mhacks/hacker-boards-refactor/hardware/rev4/hacker-boards-refactor.brd

## EAGLE design hardware/rev4/hacker-boards-refactor.brd (2016-09-08)

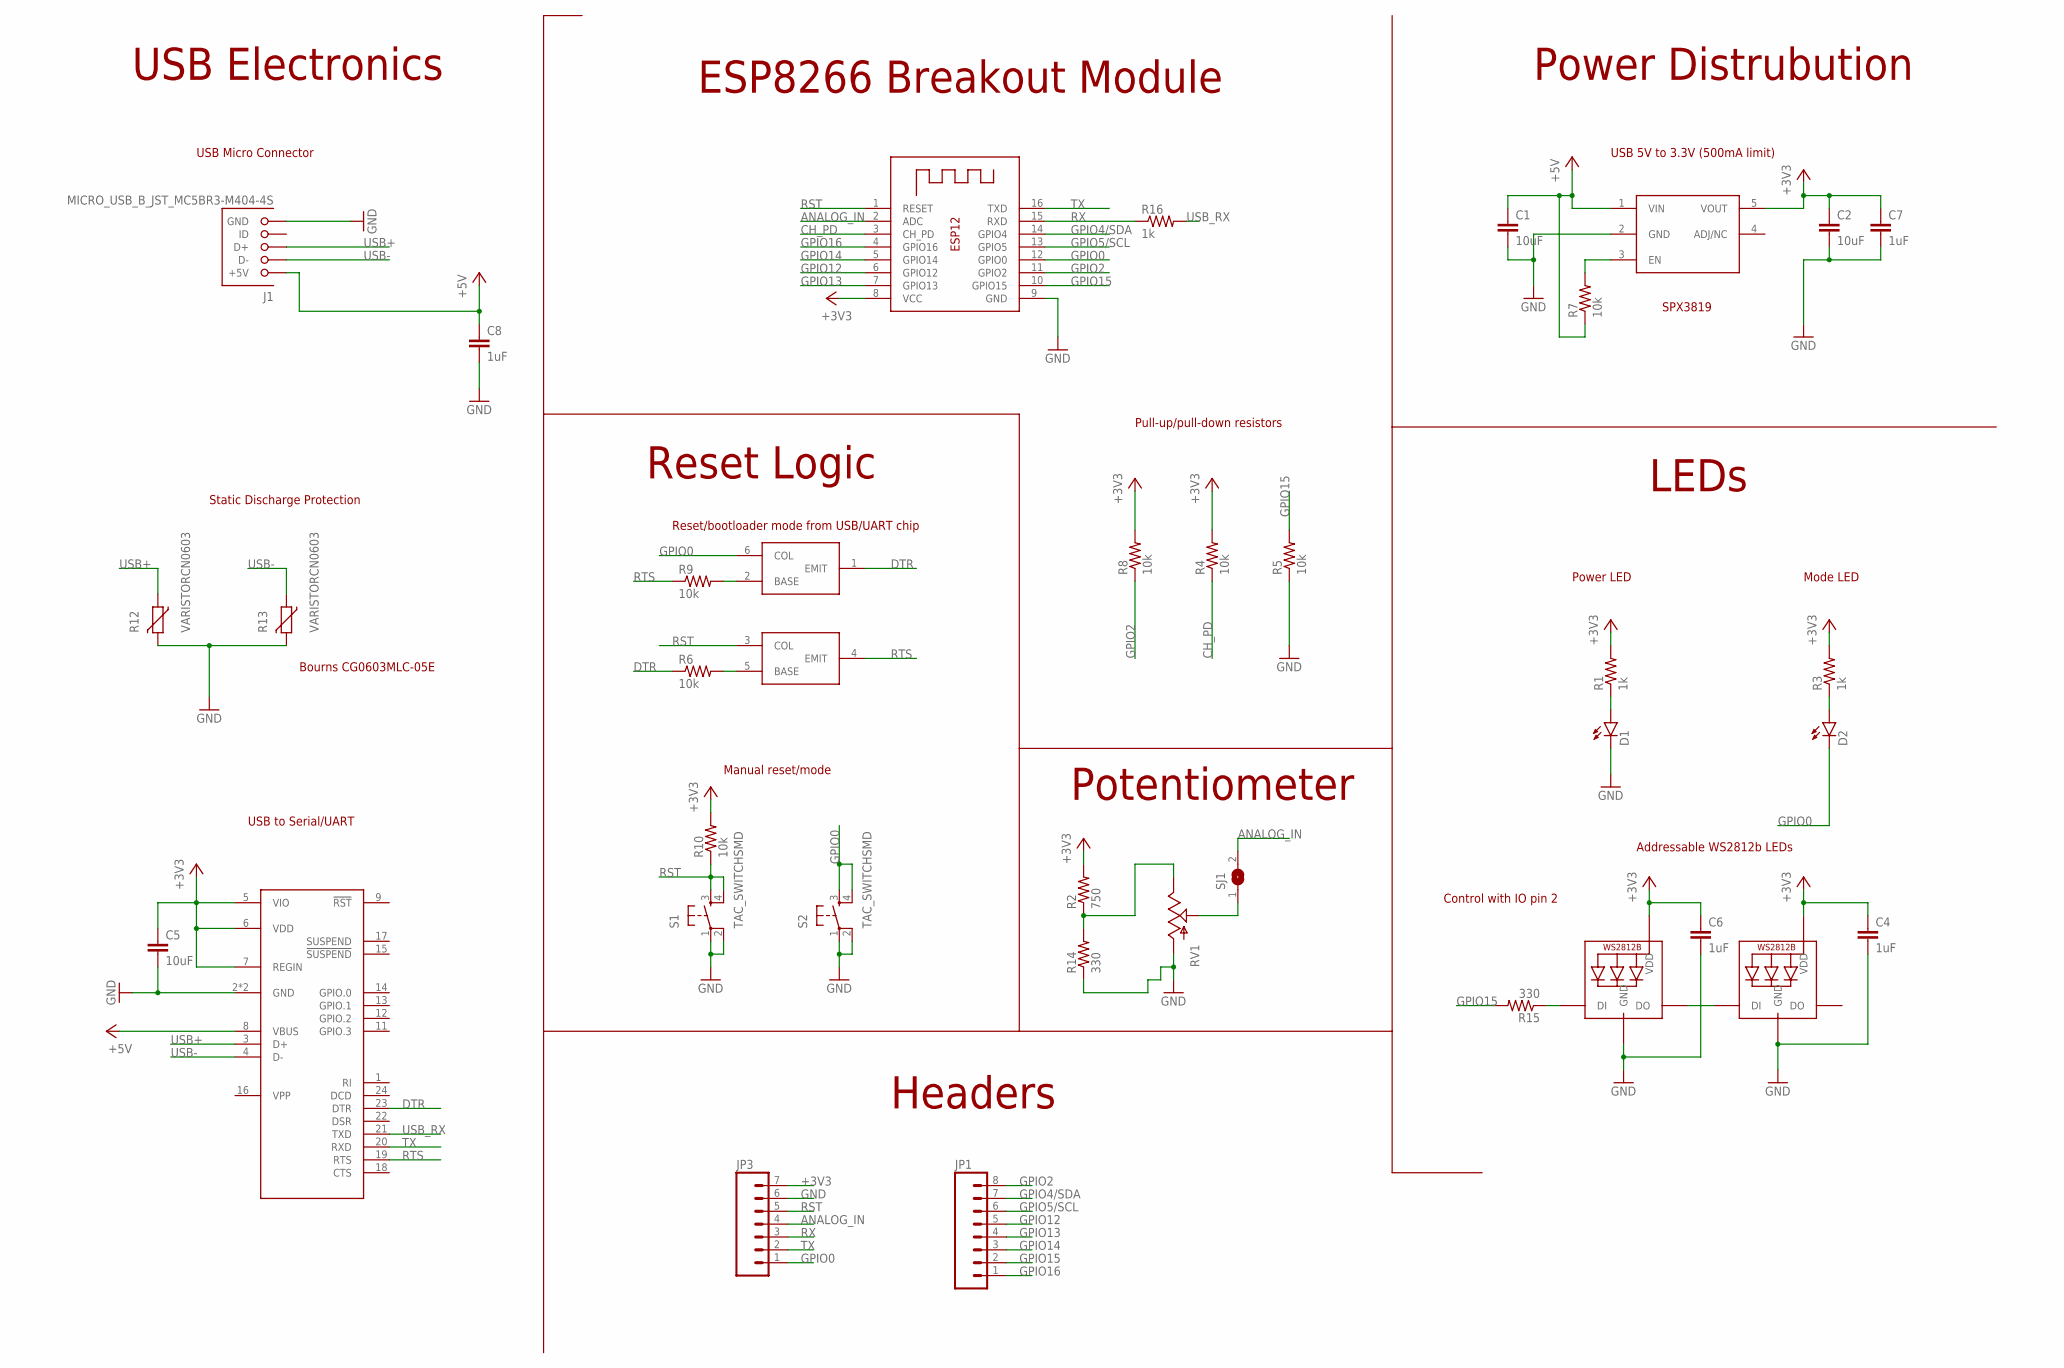
[picture p1: schematic hacker-boards-refactor.sch]

Parts:
C1, C2, C5: 10uF; C0805
C4, C6, C7, C8: 1uF; C0402
D1, D2: LED0603; LED-0603
J1: MICRO_USB_B_JST_MC5BR3-M404-4S; USB_MICRO_B-JST-MC5BR3-M404-4S-TB
JP1: M08; 1X08_ROUND
JP3: M07; 1X07
LED1, LED2: WS2812B5050; WS2812B
R1, R3, R16: 1k; R0402
R2: 750; R0402
R4, R5, R6, R7, R8, R9, R10: 10k; R0402
R12, R13: VARISTORCN0603; CT/CN0603
R14, R15: 330; R0402
RV1: POTALPS-KIT; ALPS_POT_KIT
S1, S2: TAC_SWITCHSMD; TACTILE-SWITCH-SMD
SJ1: SJ
U$2: AP2112; SOT23-5L
U$3: CP2104; QFN24_4X4
U$4: MBT3904DW1T1G; SOT363
X1: ESP-12

Connections:
+3V3: C2.1, C4.1, C5.1, C6.1, C7.1, JP3.7, LED1.1-VDD (VDD), LED2.1-VDD (VDD), R1.2, R2.2, R3.2, R4.2, R8.2, R10.2, U$2.5 (VOUT), U$3.5 (VIO), U$3.6 (VDD), U$3.7 (REGIN), X1.8 (VCC)
+5V: C1.1, C8.1, J1.1 (+5V), R7.1, U$2.1 (VIN), U$3.8 (VBUS)
ANALOG_IN: JP3.4, SJ1.2, X1.2 (ADC)
CH_PD: R4.1, X1.3 (CH_PD)
DTR: R6.1, U$3.23 (DTR), U$4.1 (EMIT)
GND: C1.2, C2.2, C4.2, C5.2, C6.2, C7.2, C8.2, D1.C, J1.5 (GND), JP3.6, LED1.3-GND (GND), LED2.3-GND (GND), R5.1, R12.2, R13.2, R14.1, RV1.P$3 (A), S1.1, S1.2, S2.1, S2.2, U$2.2 (GND), U$3.2 (GND), U$3.25 (GND), X1.9 (GND)
GPIO0: D2.C, JP3.1, S2.3, S2.4, U$4.6 (COL), X1.12 (GPIO0)
GPIO2: JP1.8, R8.1, X1.11 (GPIO2)
GPIO4/SDA: JP1.7, X1.14 (GPIO4)
GPIO5/SCL: JP1.6, X1.13 (GPIO5)
GPIO12: JP1.5, X1.6 (GPIO12)
GPIO13: JP1.4, X1.7 (GPIO13)
GPIO14: JP1.3, X1.5 (GPIO14)
GPIO15: JP1.2, R5.2, R15.2, X1.10 (GPIO15)
GPIO16: JP1.1, X1.4 (GPIO16)
unnamed: D1.A, R1.1
unnamed: D2.A, R3.1
unnamed: R2.1, R14.2, RV1.P$1 (E)
unnamed: LED1.2-DOUT (DO), LED2.4-DIN (DI)
unnamed: LED1.4-DIN (DI), R15.1
unnamed: R7.2, U$2.3 (EN)
unnamed: R9.2, U$4.2 (BASE)
unnamed: R6.2, U$4.5 (BASE)
unnamed: RV1.P$2 (S), SJ1.1
RST: JP3.5, R10.1, S1.3, S1.4, U$4.3 (COL), X1.1 (RESET)
RTS: R9.1, U$3.19 (RTS), U$4.4 (EMIT)
RX: JP3.3, R16.1, X1.15 (RXD)
TX: JP3.2, U$3.20 (RXD), X1.16 (TXD)
USB+: J1.3 (D+), R12.1, U$3.3 (D+)
USB-: J1.2 (D-), R13.1, U$3.4 (D-)
USB_RX: R16.2, U$3.21 (TXD)

Notes on the sheet:
Power Distrubution
LEDs
Headers
Potentiometer
Reset Logic
ESP8266 Breakout Module
USB Electronics
USB Micro Connector
Static Discharge Protection
USB to Serial/UART
Pull-up/pull-down resistors
Reset/bootloader mode from USB/UART chip
Manual reset/mode
Power LED
Mode LED
Addressable WS2812b LEDs
Control with IO pin 2
USB 5V to 3.3V (500mA limit)
Bourns CG0603MLC-05E
SPX3819

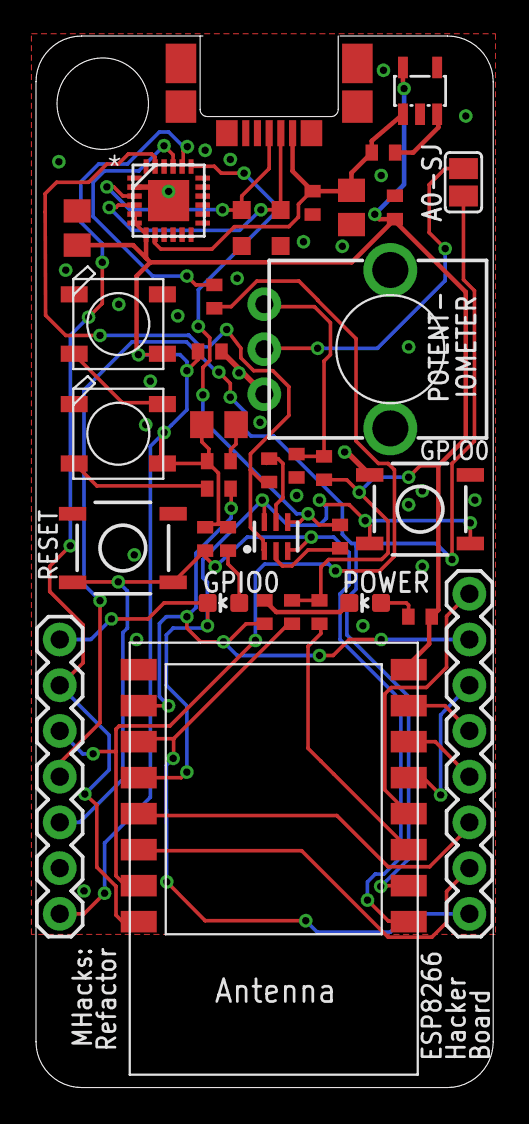
[picture p2: board hardware/rev4/hacker-boards-refactor.brd from above]

Board: 2 copper layers, 25.4 x 58.4 mm, 38 parts (1 on the bottom side), 31 nets.

Other parts of the board:
U$1: LOGO8EDGY
