mhacks/hacker-boards-refactor/(commit log)

2015-12-19 Initial Schematic Commit
    [hacker-boards-refactor.sch]
2015-12-19 Added 0402, 0603, 0805 resistors
2015-12-20 Added USB parts, reset logic, headers, LEDs. Cleaned up.
    [hacker-boards-refactor.sch]
2015-12-20 Current limiting resistor on data pin of WS2812, decoupling caps on power lines
    [hacker-boards-refactor.sch]
2015-12-20 Added potentiometer and ESD protection for USB
    [hacker-boards-refactor.sch]
2015-12-21 Initial board commit (with autorouted traces), schematic cleanup
    [hacker-boards-refactor.brd, hacker-boards-refactor.sch]
2015-12-21 Added header labels, fixed silk, cleared space for extra ESP-12 pads
    [hacker-boards-refactor.brd]
2015-12-21 Slightly enlarged board for new headers, extensively tweaked silkscreen
    [hacker-boards-refactor.brd, hacker-boards-refactor.sch]
2016-01-06 Preparing for second revision development
    [hacker-boards-refactor.brd, hacker-boards-refactor.sch]
2016-01-06 Switched all capacitors and resistors besides 10uF to 0402 for smaller production size
    [hacker-boards-refactor.brd, hacker-boards-refactor.sch]
2016-01-06 Shrank the board and re-placed components, looking for an optimized second prototyping run
    [hacker-boards-refactor.brd, hacker-boards-refactor.sch]
2016-01-07 Added 5V/3V3 traces
    [hacker-boards-refactor.brd]
2016-01-07 Removed fuse, played around/shrunk board dimensions some more
    [hacker-boards-refactor.brd, hacker-boards-refactor.sch]
2016-01-08 First pass at routing
    [hacker-boards-refactor.brd, hacker-boards-refactor.sch]
2016-01-08 Added polygons/planes to board
    [hacker-boards-refactor.brd]
2016-01-11 Added huge solder stop area in the MHacks Refactor logo form
    [hacker-boards-refactor.brd, hacker-boards-refactor.sch]
2016-01-11 Fixed D16 silkscreen
    [hacker-boards-refactor.brd]
2016-01-11 Tweaked traces to make polygons better
    [hacker-boards-refactor.brd]
2016-01-11 More polygon optimization
    [hacker-boards-refactor.brd]
2016-01-28 Updated artwork
    [hacker-boards-refactor.brd, hacker-boards-refactor.sch]
2016-02-19 Basic networking example with HTTP requests to mhacks.github.io that update the WS2812 LEDs
2016-09-01 Rev4, cleaning up a bit
    [hacker-boards-refactor.GBL, hacker-boards-refactor.GBO, hacker-boards-refactor.GBS, hacker-boards-refactor.GKO, hacker-boards-refactor.GTL, hacker-boards-refactor.GTO, hacker-boards-refactor.GTP, hacker-boards-refactor.GTS]
2016-09-07 Updated logo, small fixes on artwork
    [hacker-boards-refactor.brd]
2016-09-08 Tiny routing changes to make DRC happy
    [hacker-boards-refactor.brd]
2020-09-08 quick serial output fix
    [networking.ino]
